StellaDaniele/Embedded-Software-Project/Schematic_kicad/schematic.pdf

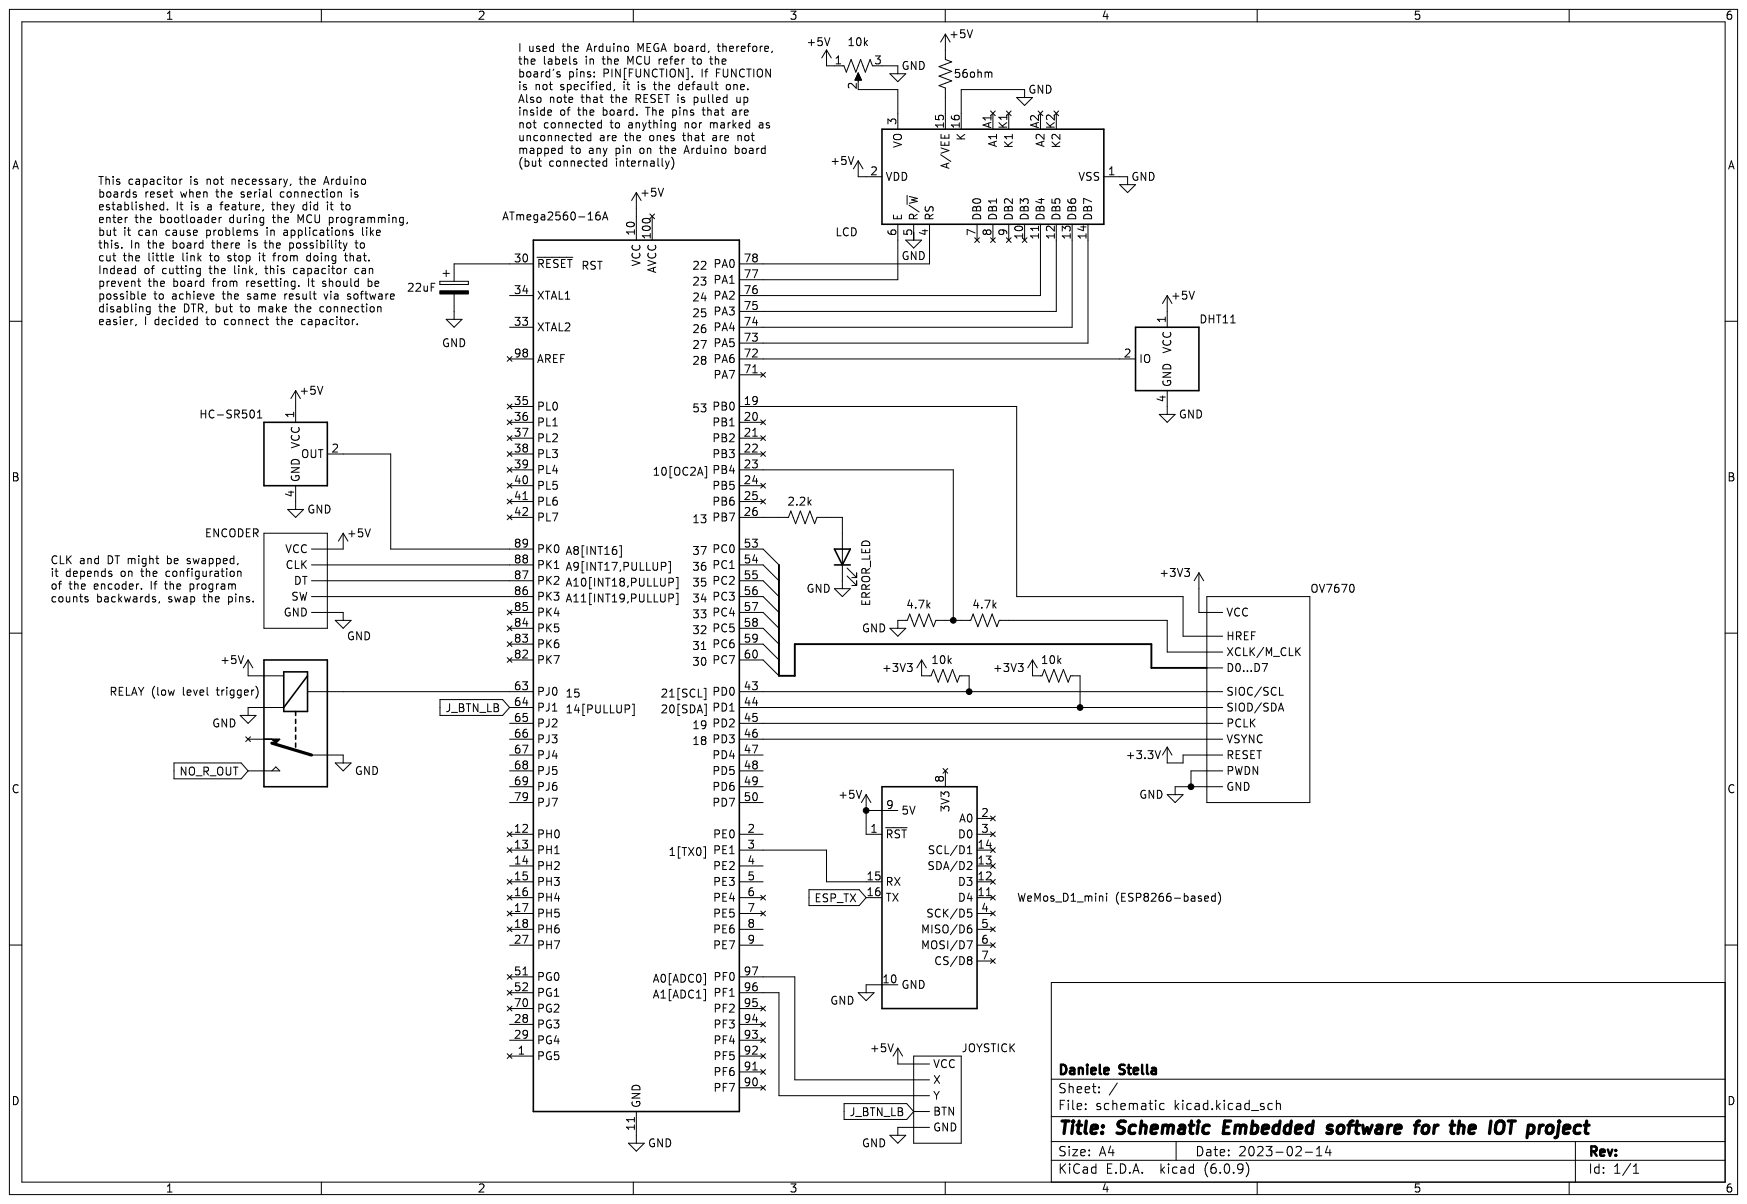
[picture p6: page 1]
