StellaDaniele/Embedded-Software-Project/Code/include/general.h

/**
 * @file general.h
 * @brief Functions for initializing the ATmega2560 microcontroller (timers and external interrupts)
 */

#ifndef __GENERAL_H__
#define __GENERAL_H__

#include <avr/io.h>
#include <stdbool.h>
#include <stdint.h>

// Relay
#define DDR_RELAY DDRJ
#define PORT_RELAY PORTJ
#define RELAY PORTJ0
// PIR HC-SR501
#define DDR_PIR DDRK
#define PIN_PIR PINK
#define PIR PINK0
// Encoder
#define DDR_ENCODER_CLK DDRK
#define PIN_ENCODER_CLK PINK
#define PORT_ENCODER_CLK PORTK
#define ENCODER_CLK PINK1

#define DDR_ENCODER_DT DDRK
#define PIN_ENCODER_DT PINK
#define PORT_ENCODER_DT PORTK
#define ENCODER_DT PINK2

#define DDR_ENCODER_SW DDRK
#define PIN_ENCODER_SW PINK
#define PORT_ENCODER_SW PORTK
#define ENCODER_SW PINK3

// Incremented each 1ms by timer1
extern volatile uint64_t curr_time_ms;

// Starts from 0, incremented by 1 when CW decremented by 1 when CCW
extern volatile int8_t encoder_position;

extern volatile bool encoder_sw_pressed_interrupt;
extern volatile bool encoder_changed;

/**
 * @brief Initializes the board by setting up pins and configuring Timer 1 to generate interrupts every 1ms.
 */
void board_init(void);

/**
 * @brief Enables the interrupt for the rotary encoder on pins CLK, DT, and SW.
 */
void enable_encoder_interrupt(void);

/**
 * @brief Disables the interrupt for the rotary encoder on pins CLK, DT, and SW.
 */
void disable_encoder_interrupt(void);

#endif
