StellaDaniele/Embedded-Software-Project/(commit log)

2022-10-19 added OV7670 driver working for atmetga328p
2022-10-19 fix imports and new test with camera and LCD together
    [camera_setup.c, capture.c, utilities.c]
2022-10-20 added DHT11 Temperature and Humidity sensor
2022-10-23 mv test5 and fix readme
    [test5_joystick_menu_LCD.c, test5_menu.c]
2022-10-23 menu with dht11 and relay
2022-10-23 menu with dht11, relay and camera
2022-11-14 before working on camera bug
    [main.c, test2_OC7670.c, test6_prototype.c, utilities.c, utilities.h]
2023-02-06 board init
2023-02-06 fixed error in menu
    [menu.c, menu.h]
2023-02-07 fixed menu and moved reset function
    [general.c, general.h, menu.c, menu.h, utilities.c, utilities.h]
2023-02-07 added external interrupt central btn
2023-02-07 fixed two mistakes in joystick
    [joystick.c, joystick.h]
2023-02-08 fixed mistake, added debugging info
    [camera_setup.c]
2023-02-08 fixed typo, moved timer management
    [general.c, general.h]
2023-02-08 moved timer ISR
2023-02-08 added central joystick button interrupt
2023-02-08 added back button in states and sampling via timer
2023-02-08 added debouncing and HC-SR501 PIR sensor
2023-02-08 fixed program ignoring keyboardinterrupt, deleted useless thread
    [main.py]
2023-02-08 added encoder with ISR
2023-02-08 added settings state and heater automatic control
2023-02-08 added reset theshold button w interrupt and boundaries
    [general.c, states_functions.c, states_functions.h]
2023-02-09 incompatibility problems, I must use Arduino IDE for web server
    [Web_server.ino]
2023-02-09 kind of works, performance issues
    [Web_server.ino]
2023-02-14 moved tests and added Arduino UNO rapid prototypes
2023-02-14 added schematic
    [schematic kicad.kicad_pcb, schematic kicad.kicad_sch]
2023-02-16 minor fixes
    [schematic kicad.kicad_sch]
